JuanVelandia78/minisumo/pcb/render_top.png

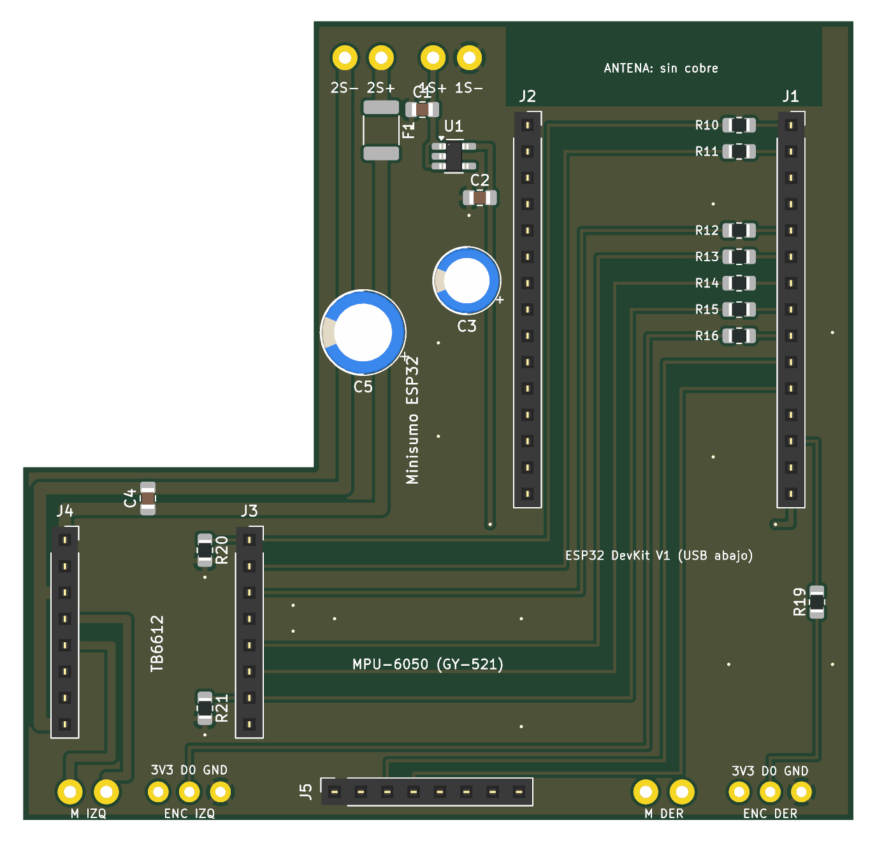
pcb/render_top.png
