JuanVelandia78/minisumo/ros2/minisumo_ros/meshes/soportes.stl

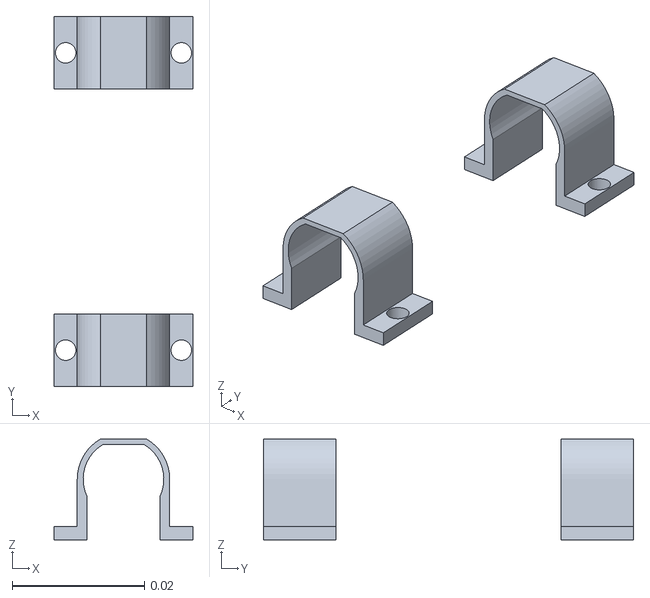
[picture p5: CAD file, 2026-11-09]
ros2/minisumo_ros/meshes/soportes.stl
0.021 x 0.056 x 0.0153
