JuanVelandia78/minisumo/ros2/minisumo_ros/meshes/chasis.stl

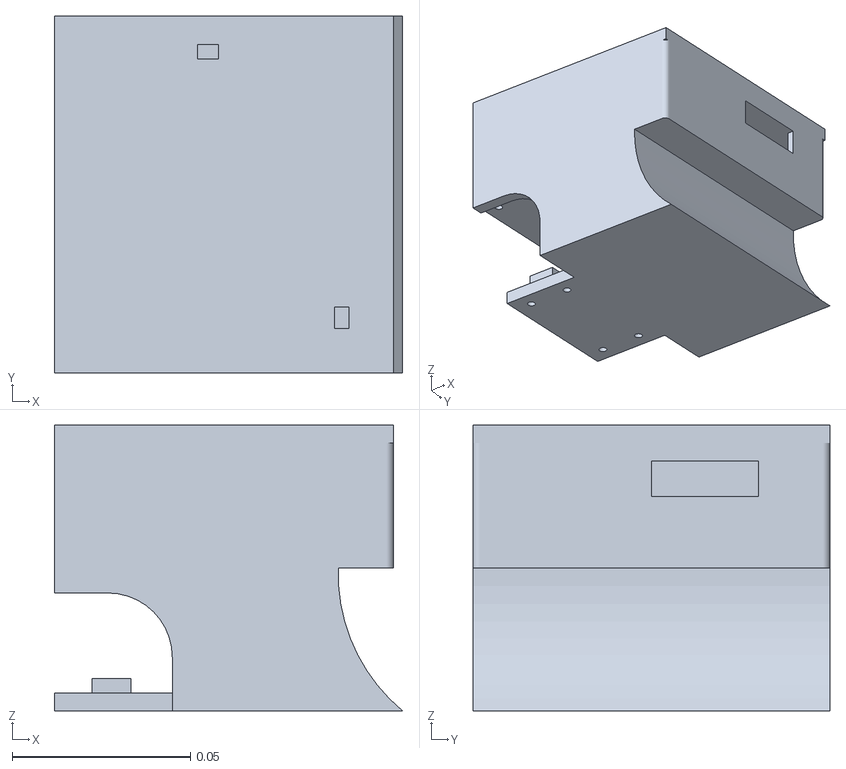
[picture p6: CAD file, 2026-11-09]
ros2/minisumo_ros/meshes/chasis.stl
0.0975 x 0.1 x 0.08
