JuanVelandia78/minisumo/ros2/minisumo_ros/meshes/rueda_der.stl

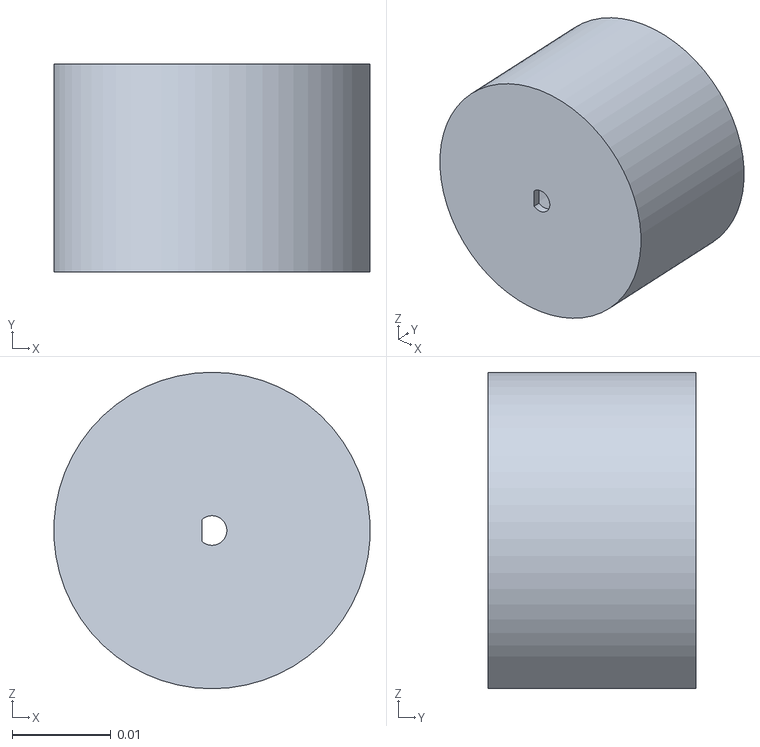
[picture p7: CAD file, 2026-11-09]
ros2/minisumo_ros/meshes/rueda_der.stl
0.032 x 0.021 x 0.032
