JuanVelandia78/minisumo/ros2/minisumo_ros/meshes/motores.stl

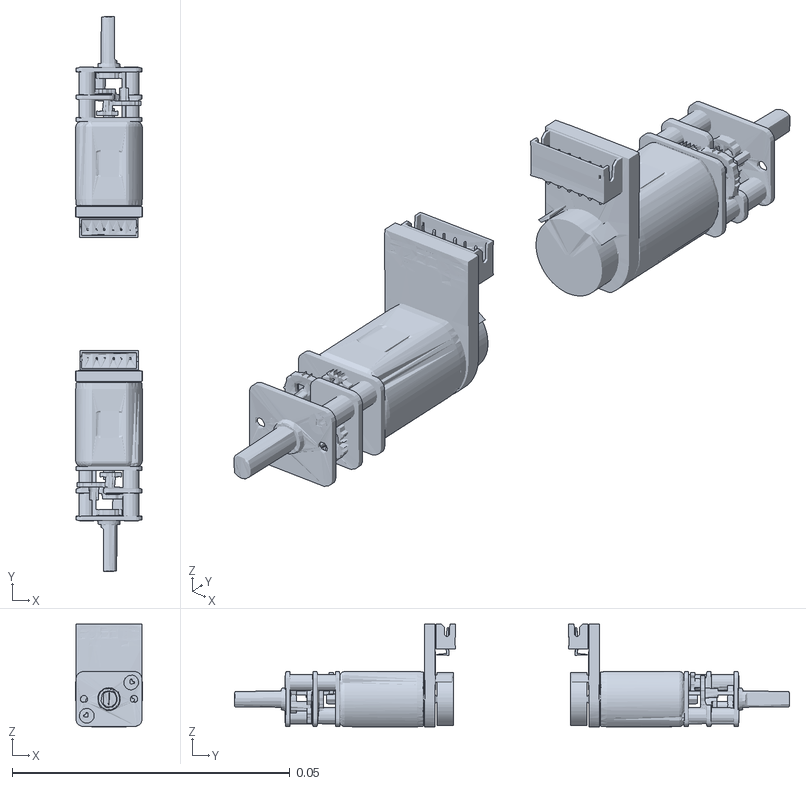
[picture p8: CAD file, 2026-11-09]
ros2/minisumo_ros/meshes/motores.stl
0.012 x 0.1 x 0.0185
