JuanVelandia78/minisumo/docs/img/manual_celular.png

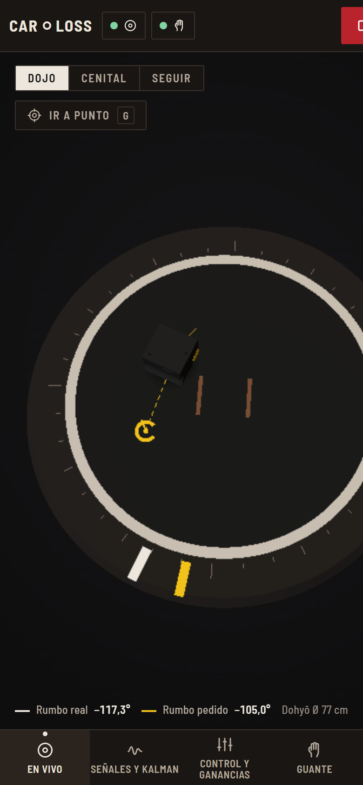
docs/img/manual_celular.png
