JuanVelandia78/minisumo/pcb/minisumo_esp32.kicad_pcb

## KiCad design pcb/minisumo_esp32.kicad_pcb (2026-10-25)

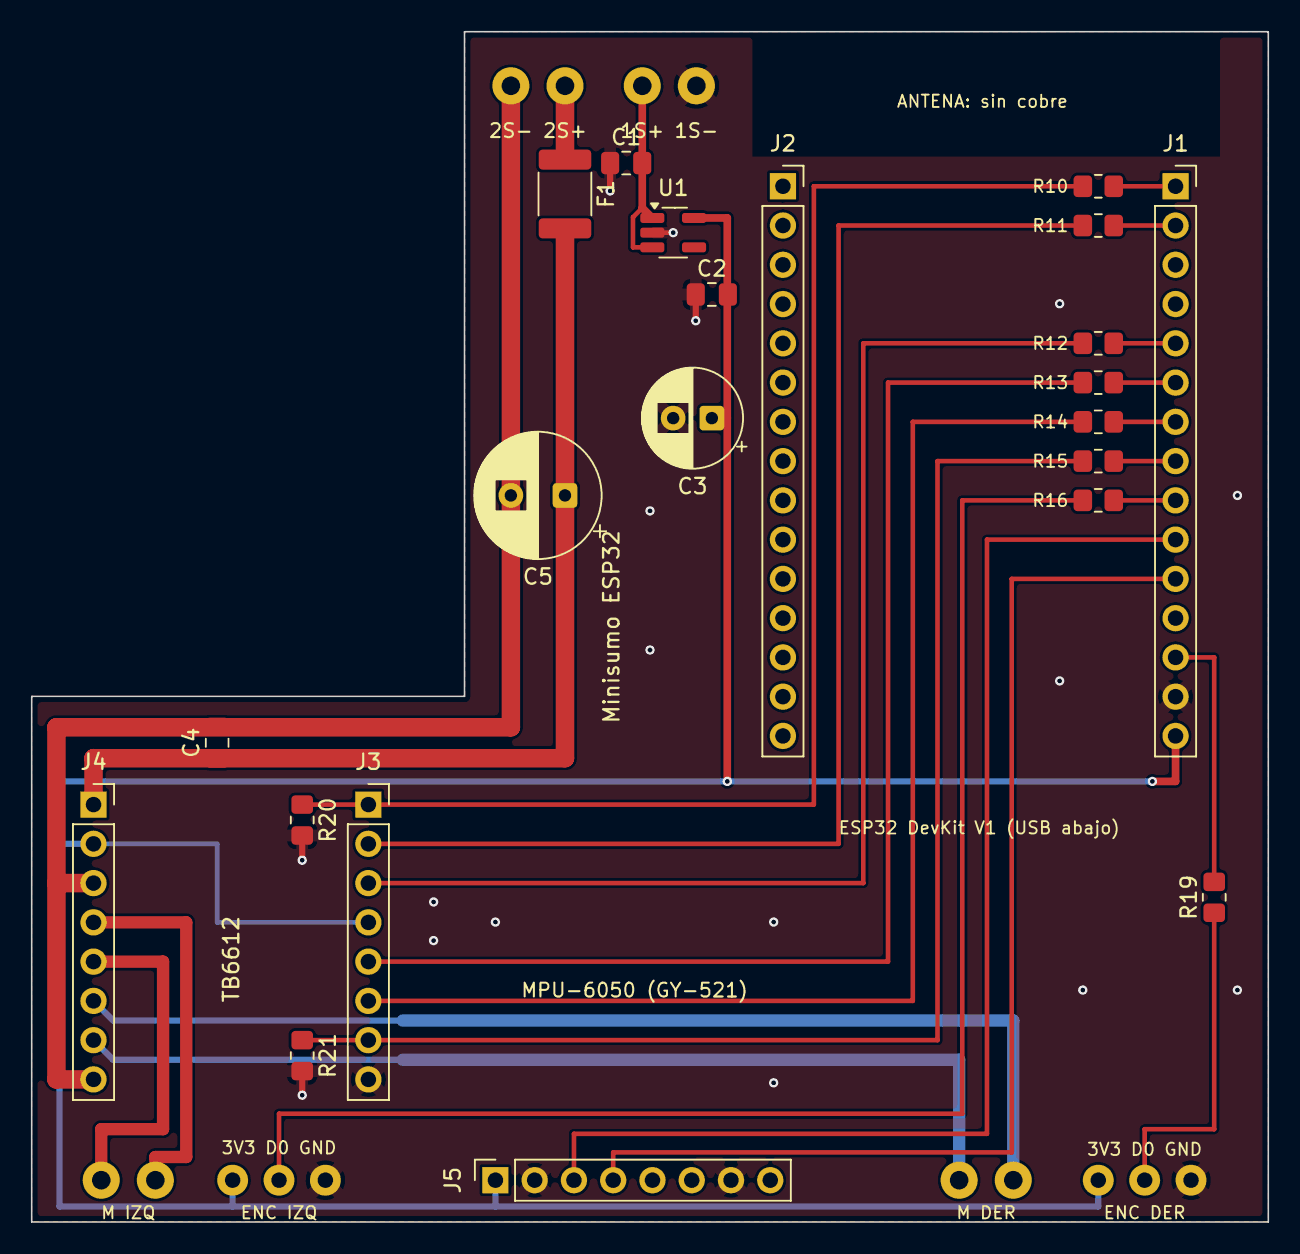
[picture p20: board minisumo_esp32.kicad_pcb from above]

Board: 2 copper layers, 80.0 x 77.0 mm, 36 parts (0 on the bottom side), 28 nets.

Parts:
BAT1N: 1S -
BAT1P: 1S +
BAT2N: 2S -
BAT2P: 2S +
C1, C2: 1uF; C_0805_2012Metric_Pad1.18x1.45mm_HandSolder
C3: 100uF 10V; CP_Radial_D6.3mm_P2.50mm
C4: 100nF; C_0805_2012Metric_Pad1.18x1.45mm_HandSolder
C5: 470uF 16V; CP_Radial_D8.0mm_P3.50mm
ELD: Enc izq D0
ELG: Enc izq GND
ELV: Enc izq 3V3
ERD: Enc der D0
ERG: Enc der GND
ERV: Enc der 3V3
F1: PTC 1A; Fuse_1812_4532Metric_Pad1.30x3.40mm_HandSolder
J1: ESP32 fila derecha; PinSocket_1x15_P2.54mm_Vertical
J2: ESP32 fila izquierda (soporte); PinSocket_1x15_P2.54mm_Vertical
J3: TB6612 control; PinSocket_1x08_P2.54mm_Vertical
J4: TB6612 potencia; PinSocket_1x08_P2.54mm_Vertical
J5: MPU-6050 GY-521; PinSocket_1x08_P2.54mm_Vertical
MA1, MA2: Motor izq.
MB1, MB2: Motor der.
R10, R11, R12, R13, R14, R15: 220; R_0805_2012Metric_Pad1.20x1.40mm_HandSolder
R16, R19: 1k; R_0805_2012Metric_Pad1.20x1.40mm_HandSolder
R20, R21: 10k; R_0805_2012Metric_Pad1.20x1.40mm_HandSolder
U1: XC6220B331MR; SOT-23-5_HandSoldering

Connections:
+3V3: C2.2, C3.1, ELV.1, ERV.1, J1.15, J3.4, J4.2, J5.1, U1.5
AIN1: J3.3, R12.1
AIN1_ESP: J1.5, R12.2
AIN2: J3.2, R11.1
AIN2_ESP: J1.2, R11.2
AO1: J4.4, MA2.1
AO2: J4.5, MA1.1
BIN1: J3.5, R13.1
BIN1_ESP: J1.6, R13.2
BIN2: J3.6, R14.1
BIN2_ESP: J1.7, R14.2
BO1: J4.7, MB1.1
BO2: J4.6, MB2.1
ENCL: ELD.1, R16.1
ENCL_ESP: J1.9, R16.2
ENCR: ERD.1, R19.1
ENCR_ESP: J1.13, R19.2
GND: BAT1N.1, C1.1, C2.1, C3.2, ELG.1, ERG.1, J1.14, J3.8, J5.2, J5.7, R20.2, R21.2, U1.2
GND_MOT: BAT2N.1, C4.2, C5.2, J4.3, J4.8
PWMA: J3.1, R10.1, R20.1
PWMA_ESP: J1.1, R10.2
PWMB: J3.7, R15.1, R21.1
PWMB_ESP: J1.8, R15.2
SCL: J1.10, J5.3
SDA: J1.11, J5.4
VBAT1: BAT1P.1, C1.2, U1.1, U1.3
VBAT2: BAT2P.1, F1.1
VM: C4.1, C5.1, F1.2, J4.1
