JuanVelandia78/minisumo/firmware/guante/main/mpu6050.h

// MPU-6050 por I2C por software (bit-bang)
#pragma once
#include "esp_err.h"

typedef struct {
    float ax, ay, az;   // g
    float gx, gy, gz;   // grados/s, sin bias
    float temp;         // °C, sensor interno del MPU-6050
} imu_sample_t;

esp_err_t mpu_init(void);
esp_err_t mpu_read(imu_sample_t *out);
// Promedia n lecturas con la mano quieta y guarda el bias del giroscopio.
esp_err_t mpu_calibrate_gyro(int n);
// Ajuste lento del bias del giroscopio con la mano quieta (s es una lectura ya corregida)
void mpu_track_bias(const imu_sample_t *s, float alpha);
