JuanVelandia78/minisumo/firmware/robot_esp32/main/wifi_secrets.example.h

// Copia este archivo como wifi_secrets.h y pon los datos de tu red.
// El robot, el guante y el PC con ROS2 deben estar en la misma red.
#pragma once
#define WIFI_SSID "nombre_de_la_red"
#define WIFI_PASS "contraseña_de_la_red"
