JuanVelandia78/minisumo/(commit log)

2026-10-09 Informe: titulo Minisumo y solo el contenido disponible hasta ahora
2026-10-25 glove_teleop: pedir al guante que envíe directo (unicast)
    El broadcast del guante llega mal a través de un hotspot de celular
    (6-14 de los 50 paquetes por segundo). glove_teleop envía "GLP" al
    guante cada 0,5 s y el guante pasa a enviarle los datos directamente.
2026-10-25 glove_teleop: zona muerta propia para el giro y alabeo atenuado con la mano muy inclinada
    En reposo la mano queda ladeada 6-10° y el robot giraba solo; el giro
    tiene ahora su propia zona muerta (12°). Con la mano cerca de la vertical
    el alabeo pierde sentido: su peso baja con el coseno del cabeceo y se
    anula pasando 60°.
2026-10-25 glove_teleop: opción swap_axes para un MPU montado girado 90°
2026-10-25 Robot con ESP32 DevKit y batería 3S, guante actualizado y PCB
    - firmware/robot_esp32: versión actual del robot (ESP32 DevKit V1).
    Encoders solo con flanco de subida y confirmación de 50 us, modelo del
    motor medido con 3S, PWM limitado a 0,55, PID de rueda apagado y rumbo
    en cascada con el giroscopio, rampa de velocidad, calibración del
    giroscopio que se repite si el robot se movió, timeout de 700 ms.
    - firmware/robot: ajustes pendientes de la primera versión (ESP32-C3).
    - firmware/guante: ESP32 DevKit, corrección del paso por ±180°,
    monitoreo de ángulos y temperatura, envío directo al PC al recibir GLP.
    - pcb: PCB del robot para la ESP32 DevKit (KiCad 10).
    - README: vers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
2026-10-26 Encoders: rechazar el pulso falso de mitad de ranura
    Con los motores andando el LM393 (sin histéresis) daba un pulso extra
    por ranura y la odometría estimaba el doble de la distancia real. El
    filtro adaptativo ahora rechaza flancos antes del 70 % del intervalo
    anterior, con tope de 80 ms. Probado en el piso: error de distancia
    de unos 2 cm en tramos de 14-18 cm (antes 2 a 4,5 veces lo real).
2026-10-26 Visualización en RViz2: dojo, robot, trayectoria y mano del operador
    - visualizer: TF odom->base_link y odom->mano, MarkerArray con el dojo
    de 77 cm, el robot y la mano inclinada, trayectoria (/minisumo/path)
    y textos con la posición estimada y la orden de movimiento.
    - glove_teleop publica /glove/hand_angles ya corregidos (swap/invert).
    - launch/visualizacion.launch.py abre puente, cinemática, visualizador,
    RViz2 configurado y, con guante:=true, el guante.
2026-10-26 Señales antes y después del filtrado: IMU de la mano y graficador
    - guante: IIR Butterworth (orden 2, fc 10 Hz a 100 Hz) sobre la IMU
    cruda; el paquete GL agrega ax..gz crudos y filtrados.
    - glove_teleop publica /glove/imu/raw y /glove/imu/filtered.
    - signal_plotter: gráficas en vivo, crudo contra filtrado, de la IMU del
    robot, los encoders, la IMU de la mano y sus ángulos, con la
    desviación estándar de cada señal en la ventana.
2026-10-26 signal_plotter: submuestrear y redibujar menos para no saturar la VM
2026-11-09 Versión final CAR-LOSS: PCB v11, Kalman, consola web, ir a punto y documentación
    Firmware del robot (PCB v11):
    - DRV8833, encoders de cuadratura con PCNT (2771 cuentas/vuelta medidas), INA219 y autodiagnóstico
    - PI de rueda con prealimentación de la curva medida y control de rumbo que mantiene el ángulo
    - Radio efectivo de rueda 16,2 mm y separación de 79 mm (ensamblaje de SolidWorks)
    ROS2:
    - kalman_filter: Kalman de la IMU, de las ruedas [w, alfa] y de los ángulos de la mano [theta, sesgo]
    - goto_controller: ir a una coordenada del dojo; diff_kinematics da prioridad al control automático
    - panel_server: consola web 3D (HTTP + WebSocket con la biblioteca estándar) con control de fl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
